Nevada317/logic_tester/images/Bot_3d.png

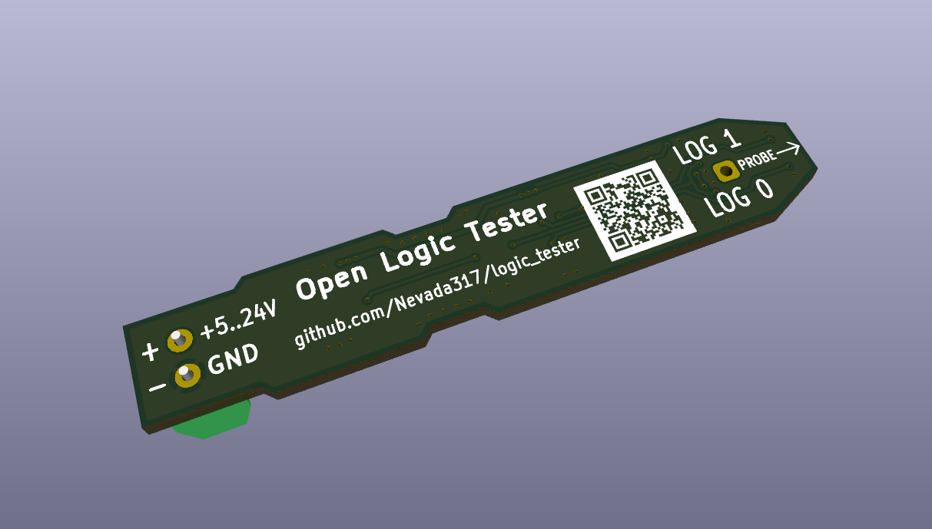
images/Bot_3d.png
