Nevada317/logic_tester/images/Top_ort.png

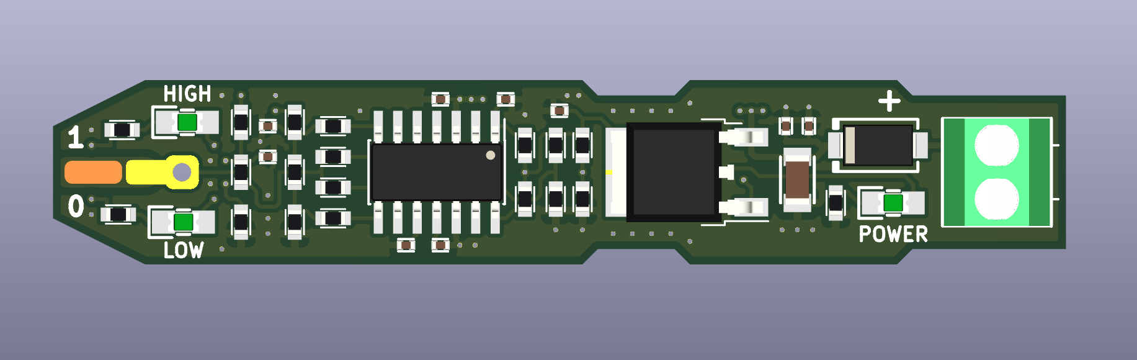
images/Top_ort.png
