Nevada317/logic_tester/images/Bot_ort.png

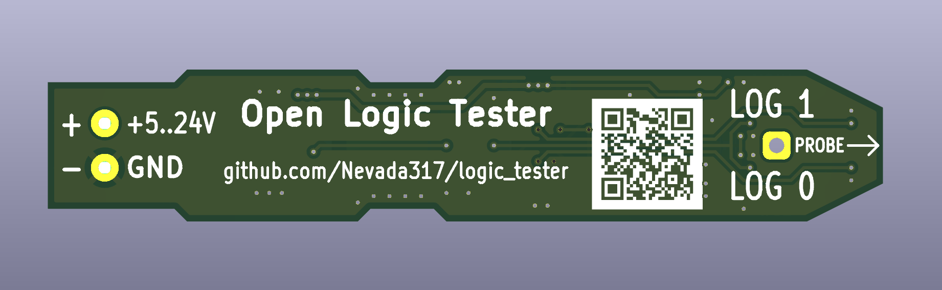
images/Bot_ort.png
