Nevada317/logic_tester/images/Top_3d.png

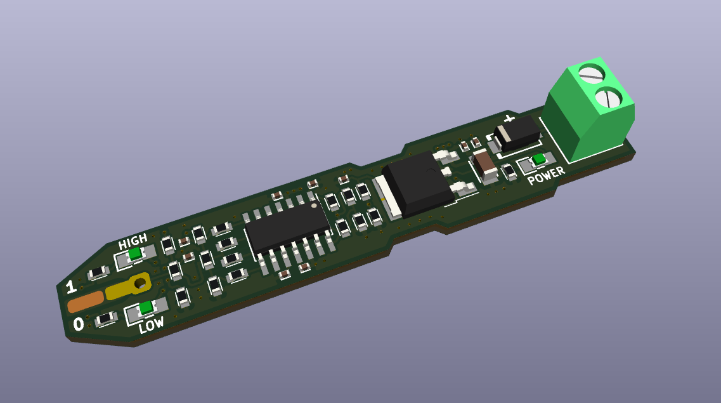
images/Top_3d.png
