Nevada317/logic_tester/logic_tester.step

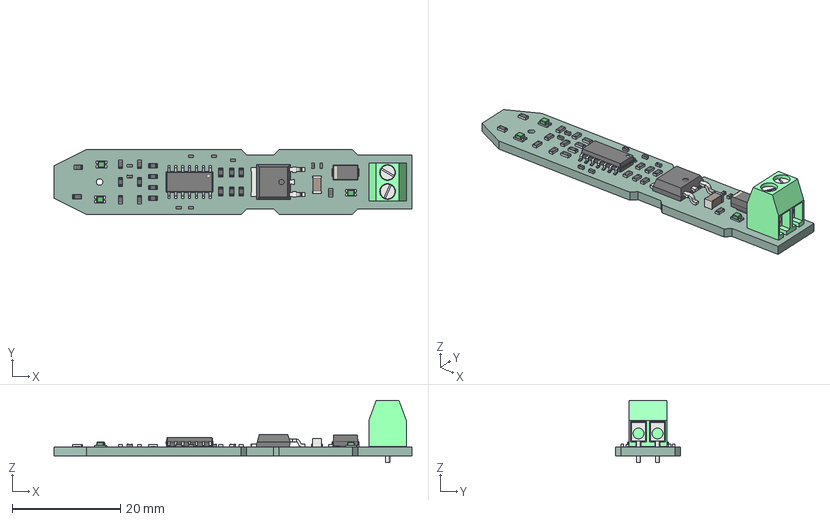
[picture p5: CAD file, 2024-11-23]
logic_tester.step
66.0 x 12.0 x 11.5 mm
C_0402_1005Metric x 9
R_0603_1608Metric x 19
Ceramic x 3
Glass x 3
SOIC_14_39x87mm_P127mm
TO_252_2
D_SMA
C_1206_3216Metric
logic_tester PCB
