Nevada317/logic_tester/logic_tester.pdf

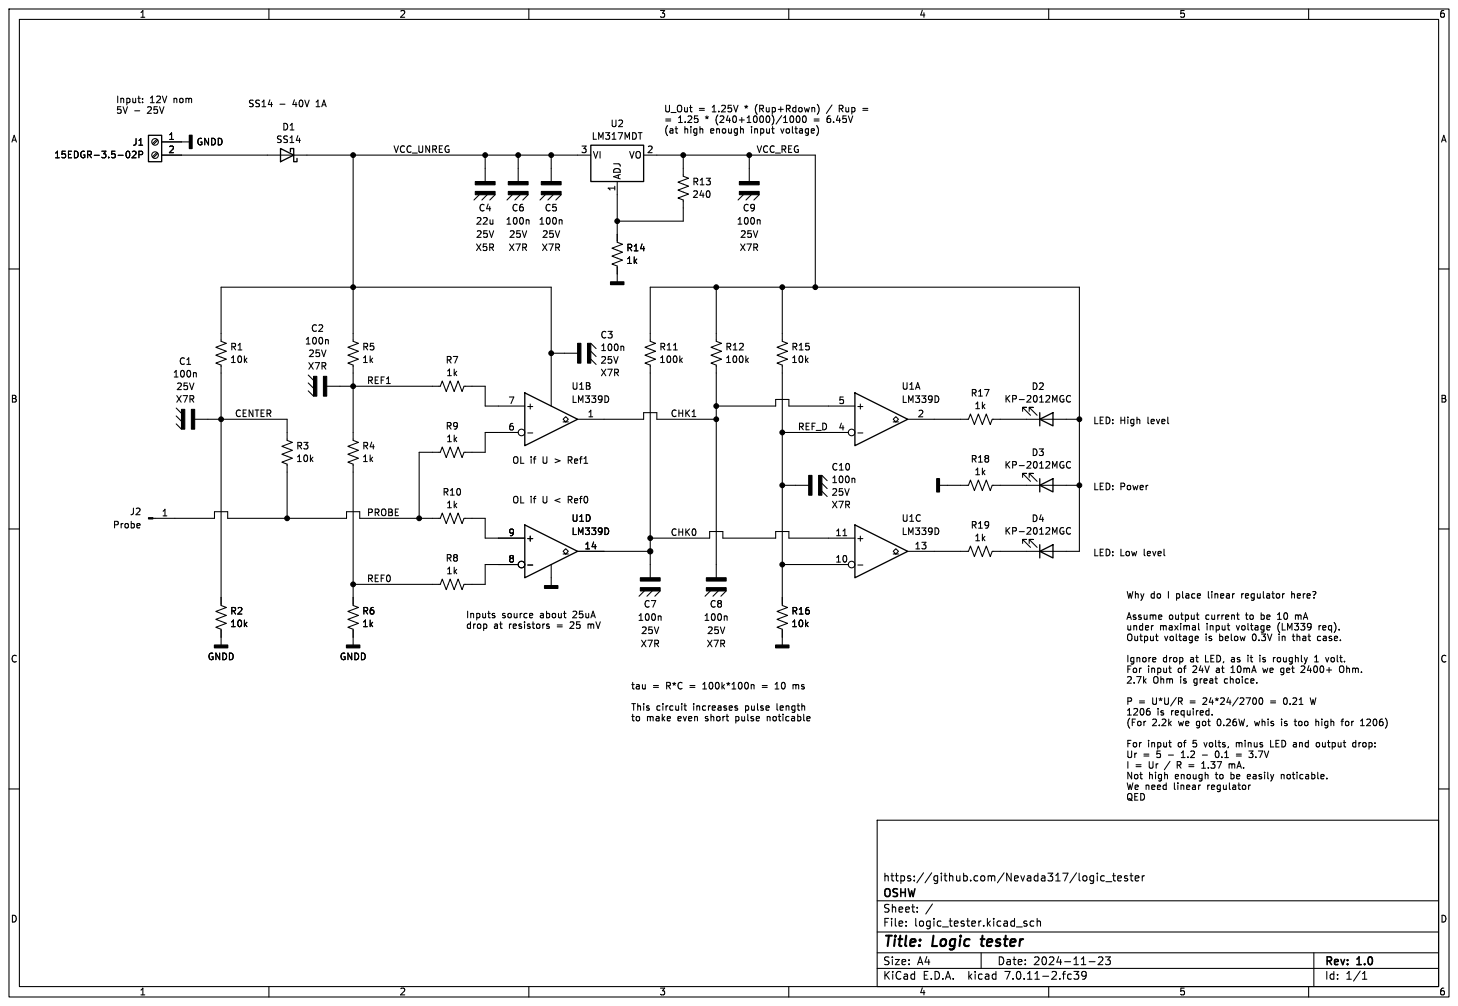
[picture p6: page 1]

(at high enough input voltage)

1206 is required.
(For 2.2k we got 0.26W, whis is too high for 1206) For input of 5 volts, minus LED and output drop: Ur = 5 - 1.2 - 0.1 = 3.7V

to make even short pulse noticable

I = Ur / R = 1.37 mA. Not high enough to be easily noticable. We need linear regulator QED

https://github.com/Nevada317/logic_tester
Id: 1/1 Title: Logic tester File: logic_tester.kicad_sch Sheet: / OSHW
