Nevada317/logic_tester/logic_tester.kicad_pcb

## KiCad design logic_tester.kicad_pcb (2024-11-23)

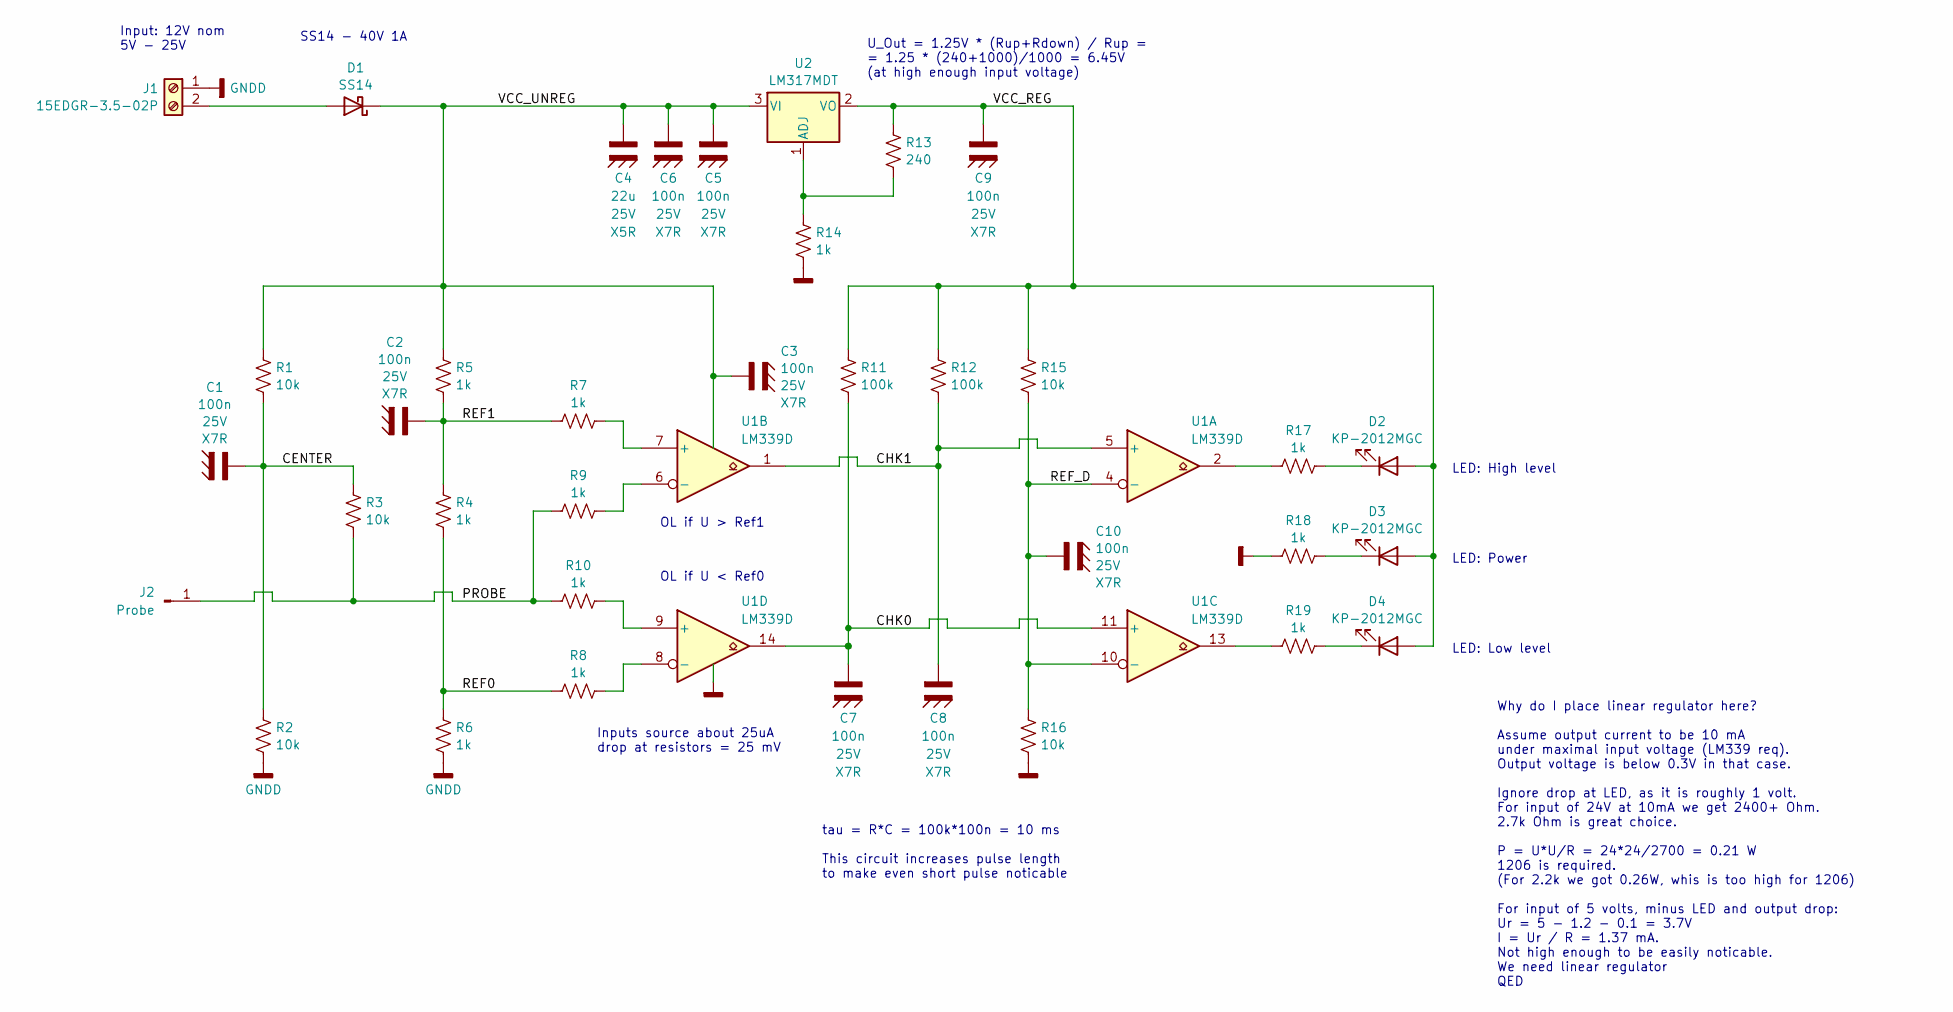
[picture p7: schematic logic_tester.kicad_sch, Logic tester]

Parts:
C1, C2, C3, C5, C6, C7, C8, C9, C10: 100n; C_0402; Voltage 25V
C4: 22u; C_1206; Voltage 25V
D1: SS14; DO-214AC_SMA
D2, D3, D4: KP-2012MGC; LED_KP-2012G
J1: 15EDGR-3.5-02P; Terminal_3.5mm_x2
J2: Probe; Pad_Wire
R1, R2, R3, R15, R16: 10k; R_0603
R4, R5, R6, R7, R8, R9, R10, R14, R17, R18, R19: 1k; R_0603
R11, R12: 100k; R_0603
R13: 240; R_0603
U1: LM339D; SOIC-14
U2: LM317MDT; D-PAK

Connections:
/CENTER: C1.1, R1.2, R2.1, R3.1
/CHK0: C7.1, R11.2, U1.11 (+), U1.14
/CHK1: C8.1, R12.2, U1.1, U1.5 (+)
/PROBE: J2.1, R3.2, R9.1, R10.1
/REF0: R4.2, R6.1, R8.1
/REF1: C2.1, R4.1, R5.2, R7.1
/REF_D: C10.1, R15.2, R16.1, U1.4 (-), U1.10 (-)
/VCC_REG: C9.1, D2.2 (A), D3.2 (A), D4.2 (A), R11.1, R12.1, R13.1, R15.1, U2.2 (VO)
GNDD: C1.2 (GNDD), C2.2 (GNDD), C3.2 (GNDD), C4.2 (GNDD), C5.2 (GNDD), C6.2 (GNDD), C7.2 (GNDD), C8.2 (GNDD), C9.2 (GNDD), C10.2 (GNDD), J1.1, R2.2, R6.2, R14.2, R16.2, R18.1, U1.12 (V-)
unnamed: D1.2 (A), J1.2
unnamed: D2.1 (K), R17.2
unnamed: D3.1 (K), R18.2
unnamed: D4.1 (K), R19.2
unnamed: R17.1, U1.2
unnamed: R19.1, U1.13
unnamed: R7.2, U1.7 (+)
unnamed: R9.2, U1.6 (-)
unnamed: R10.2, U1.9 (+)
unnamed: R8.2, U1.8 (-)
unnamed: R13.2, R14.1, U2.1 (ADJ)
V+: C3.1, C4.1, C5.1, C6.1, D1.1 (K), R1.1, R5.1, U1.3 (V+), U2.3 (VI)

Notes on the sheet:
Input: 12V nom 5V - 25V
SS14 - 40V 1A
OL if U > Ref1
LED: Power
Inputs source about 25uA drop at resistors = 25 mV
U_Out = 1.25V * (Rup+Rdown) / Rup = = 1.25 * (240+1000)/1000 = 6.45V (at high enough input voltage)
OL if U < Ref0
Why do I place linear regulator here? Assume output current to be 10 mA under maximal input voltage (LM339 req). Output voltage is below 0.3V in that case. Ignore drop at LED, as it is roughly 1 volt. For input of 24V at 10mA we get 2400+ Ohm. 2.7k Ohm is great choice. P = U*U/R = 24*24/2700 = 0.21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
tau = R*C = 100k*100n = 10 ms This circuit increases pulse length to make even short pulse noticable
LED: High level
LED: Low level

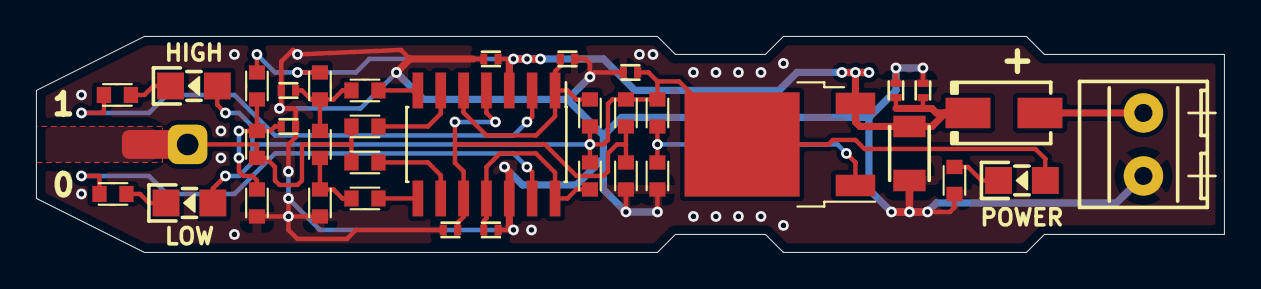
[picture p8: board logic_tester.kicad_pcb from above]

Board: 2 copper layers, 66.0 x 12.0 mm, 37 parts (0 on the bottom side), 21 nets.
