Nevada317/logic_tester/(commit log)

2024-11-22 Empty project
    [logic_tester.kicad_pcb, logic_tester.kicad_sch]
2024-11-22 Schematic idea drafted
    [logic_tester.kicad_sch]
2024-11-22 Leds with direct supply - bad idea
    [logic_tester.kicad_sch]
2024-11-22 Voltage regulator added
    [logic_tester.kicad_sch]
2024-11-22 Capacitors chosen
    [logic_tester.kicad_sch]
2024-11-22 Schematics looks OK
    [logic_tester.kicad_sch]
2024-11-22 PCB placement started
    [logic_tester.kicad_pcb]
2024-11-22 Geo reannotate
    [logic_tester.kicad_pcb, logic_tester.kicad_sch]
2024-11-22 Swap comparators for easier routing
    [logic_tester.kicad_pcb, logic_tester.kicad_sch]
2024-11-22 Input circuits layout stub
    [logic_tester.kicad_pcb]
2024-11-22 Second cascade of comparators placed
    [logic_tester.kicad_pcb]
2024-11-22 Seems fitted
    [logic_tester.kicad_pcb, logic_tester.kicad_sch]
2024-11-22 Tighter capacitor placement
    [logic_tester.kicad_pcb]
2024-11-22 Probe pad added
    [logic_tester.kicad_pcb, logic_tester.kicad_sch]
2024-11-22 Signal part routed
    [logic_tester.kicad_pcb]
2024-11-22 Routing done. PCB shortened
    [logic_tester.kicad_pcb]
2024-11-22 Size changed: 66x12
    [logic_tester.kicad_pcb]
2024-11-22 Silk work
    [logic_tester.kicad_pcb]
2024-11-22 Ground plane + more silk
    [logic_tester.kicad_pcb]
2024-11-22 Extra mask opening
    [logic_tester.kicad_pcb]
2024-11-22 Title added to sheets
    [logic_tester.kicad_pcb, logic_tester.kicad_sch]
2024-11-23 QR code added (generated by nayuki.io)
    [logic_tester.kicad_pcb]
2024-11-23 Gerbers exported
    [logic_tester-B_Cu.gbr, logic_tester-B_Fab.gbr, logic_tester-B_Mask.gbr, logic_tester-B_Paste.gbr, logic_tester-B_Silkscreen.gbr, logic_tester-Edge_Cuts.gbr, logic_tester-F_Cu.gbr, logic_tester-F_Fab.gbr]
2024-11-23 Schematic exported
    [logic_tester.kicad_sch]
2024-11-23 STEP exported
    [logic_tester.step]
